edelira/LED-Sign/enclosure/img/esp32_tray.png

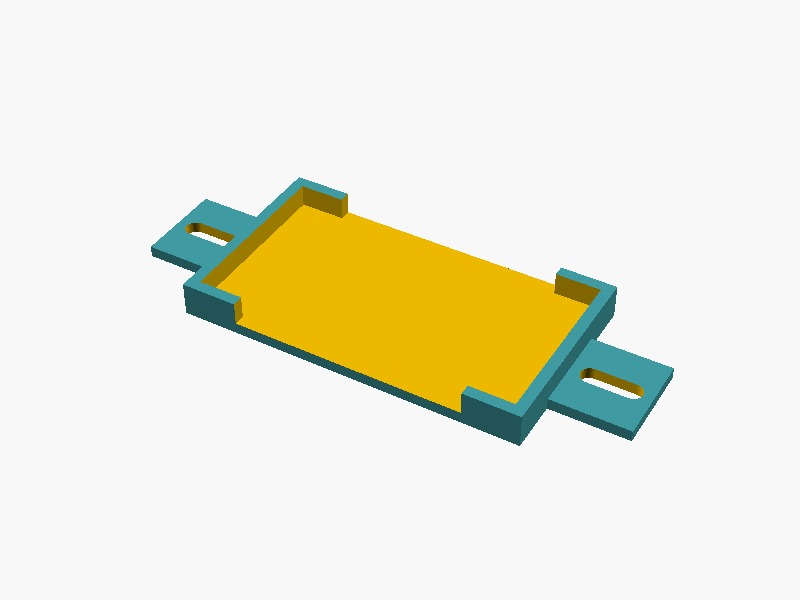
enclosure/img/esp32_tray.png
