edelira/LED-Sign/enclosure/img/hanger.png

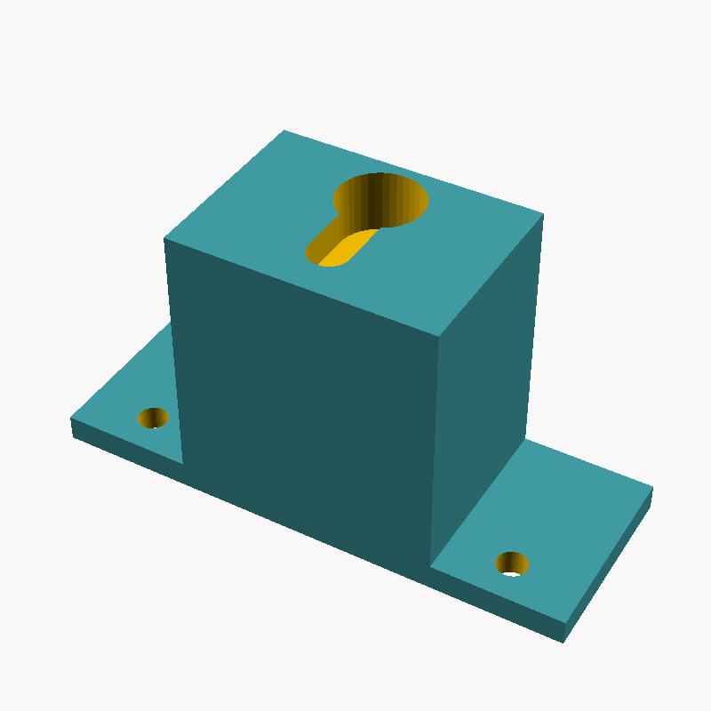
enclosure/img/hanger.png
