edelira/LED-Sign/enclosure/img/magnet_rail.png

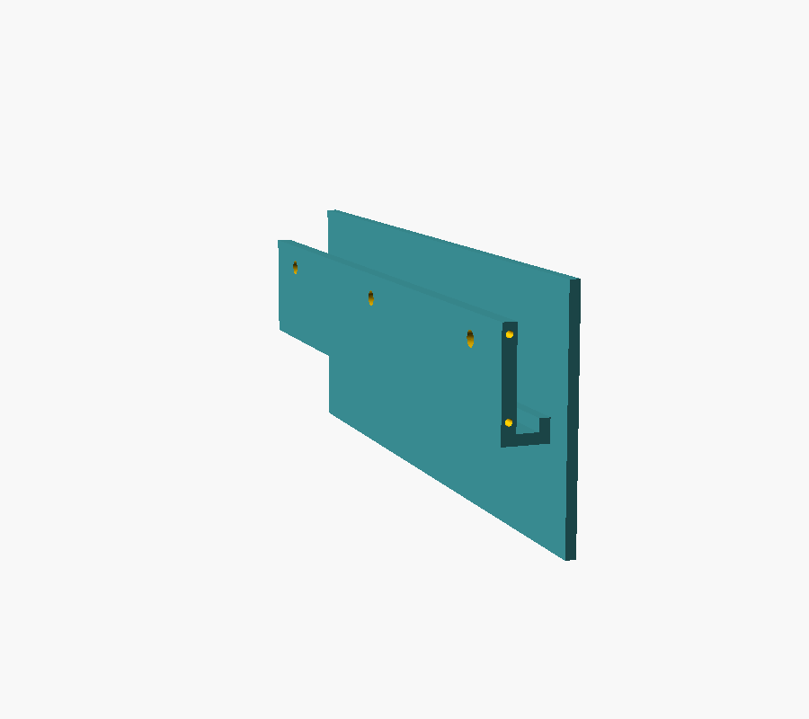
enclosure/img/magnet_rail.png
