edelira/LED-Sign/enclosure/img/magnet_rail_side.png

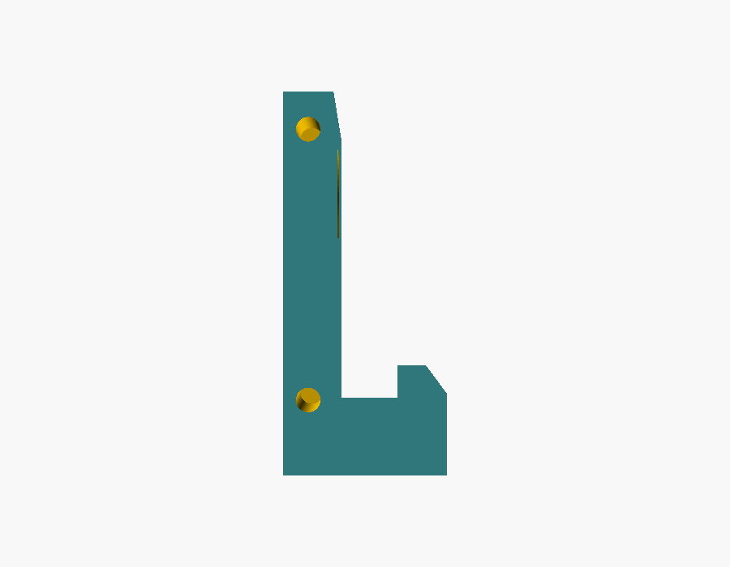
enclosure/img/magnet_rail_side.png
