edelira/LED-Sign/enclosure/img/seg_left.png

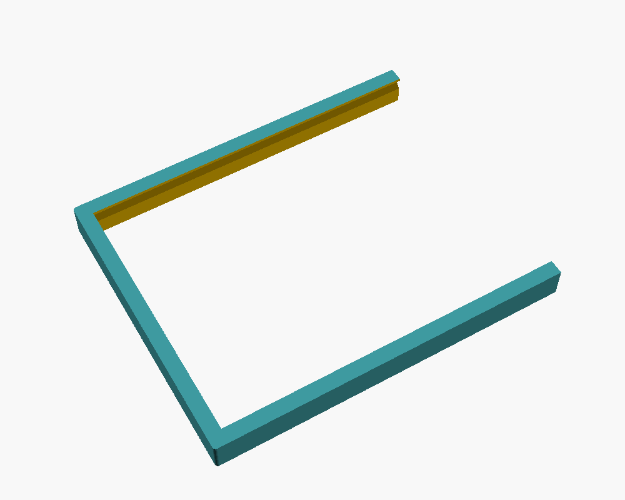
enclosure/img/seg_left.png
