edelira/LED-Sign/enclosure/stl/magnet_rail.stl

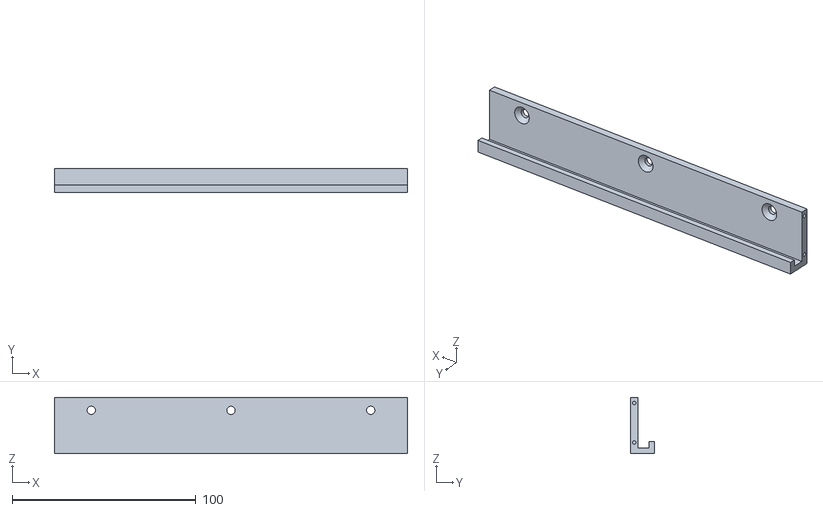
[picture p6: CAD file, 2026-10-31]
enclosure/stl/magnet_rail.stl
192.0 x 13.0 x 30.5
