edelira/LED-Sign/enclosure/stl/magnet_foot.stl

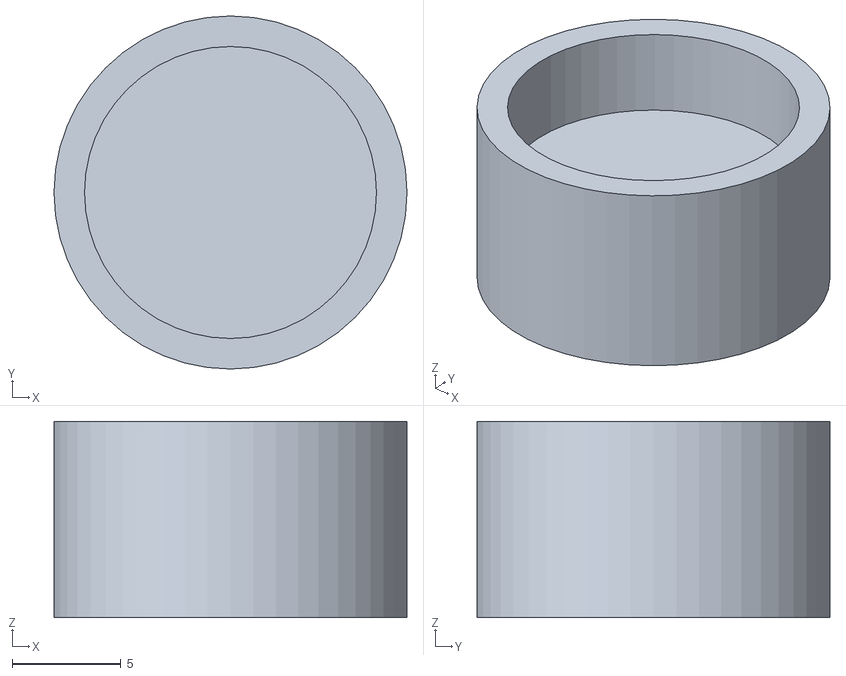
[picture p7: CAD file, 2026-10-31]
enclosure/stl/magnet_foot.stl
16.2 x 16.2 x 9.00
