edelira/LED-Sign/enclosure/stl/magnet_test.stl

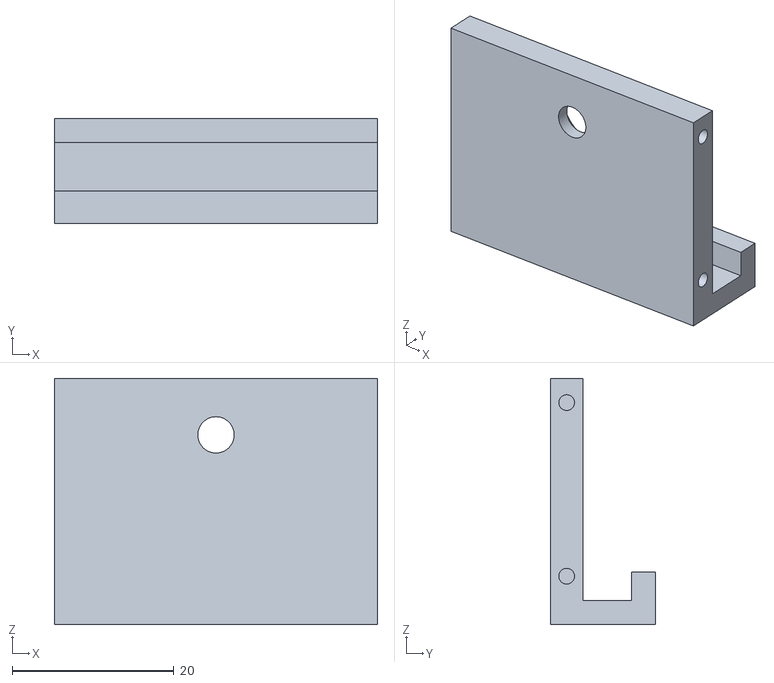
[picture p8: CAD file, 2026-10-31]
enclosure/stl/magnet_test.stl
40.0 x 13.0 x 30.5
