edelira/LED-Sign/enclosure/stl/seg_left.stl

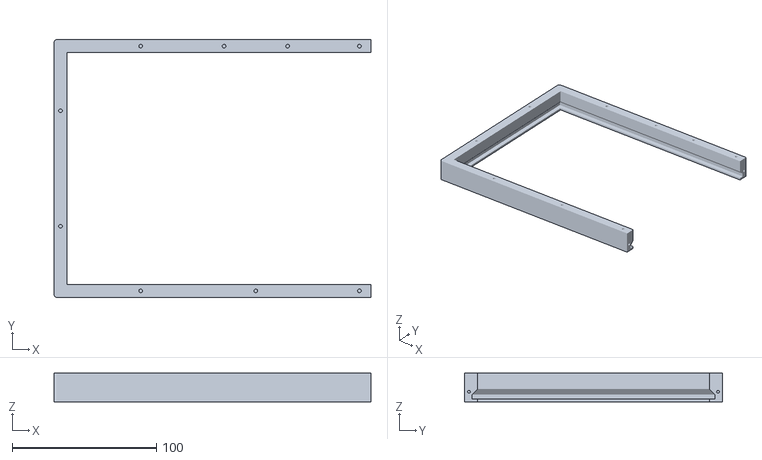
[picture p9: CAD file, 2026-10-25]
enclosure/stl/seg_left.stl
219.5 x 178.5 x 20.0
