edelira/LED-Sign/enclosure/stl/splice.stl

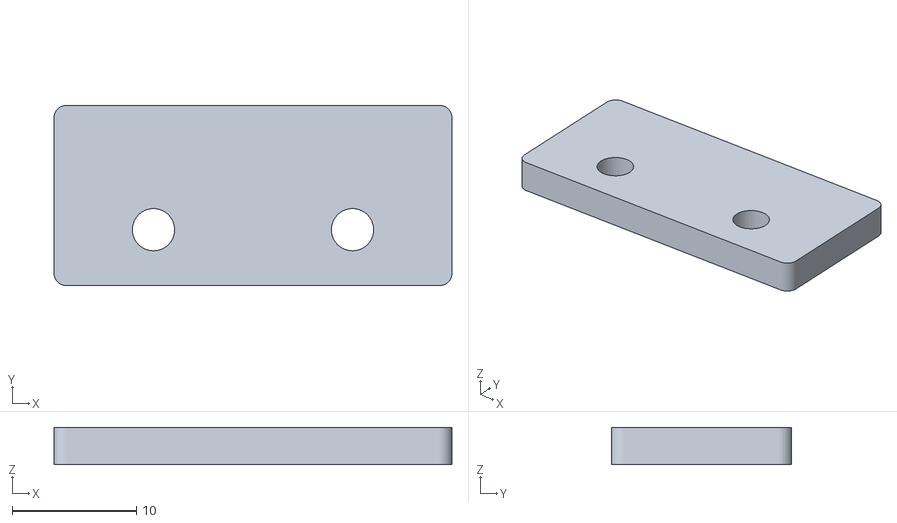
[picture p10: CAD file, 2026-10-25]
enclosure/stl/splice.stl
32.0 x 14.5 x 3.00
