edelira/LED-Sign/enclosure/stl/hanger.stl

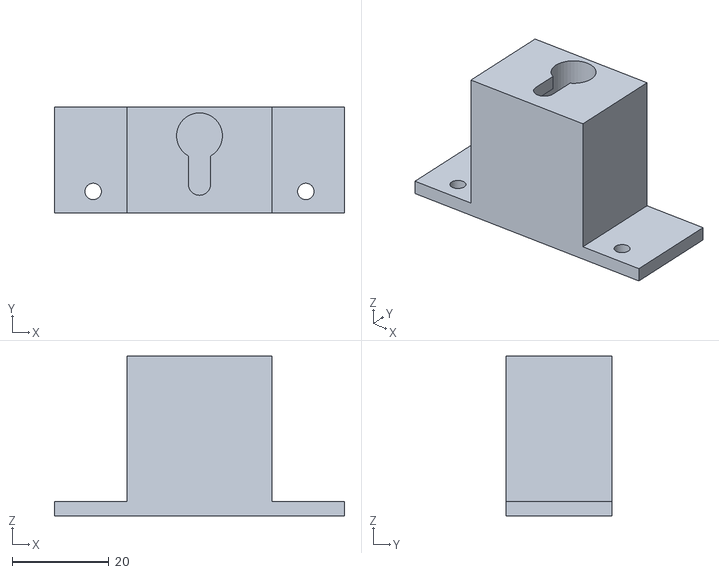
[picture p11: CAD file, 2026-10-25]
enclosure/stl/hanger.stl
60.0 x 22.0 x 33.0
