edelira/LED-Sign/enclosure/stl/seg_mid.stl

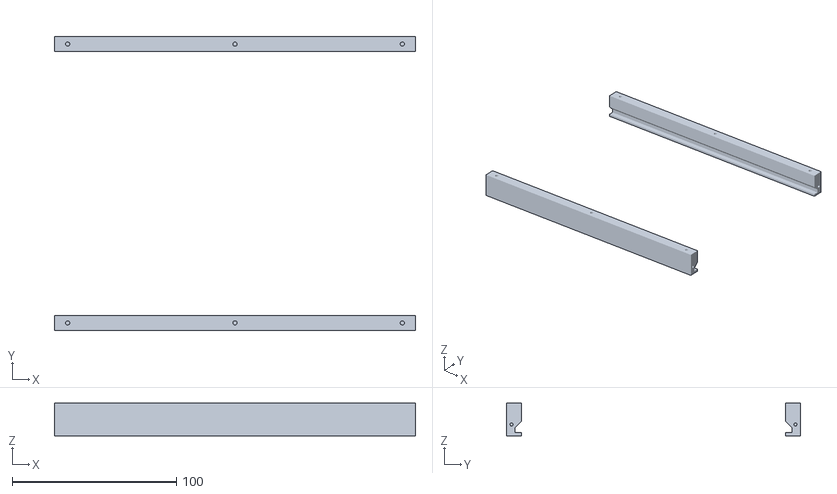
[picture p12: CAD file, 2026-10-25]
enclosure/stl/seg_mid.stl
219.5 x 178.5 x 20.0
