edelira/LED-Sign/enclosure/stl/esp32_tray.stl

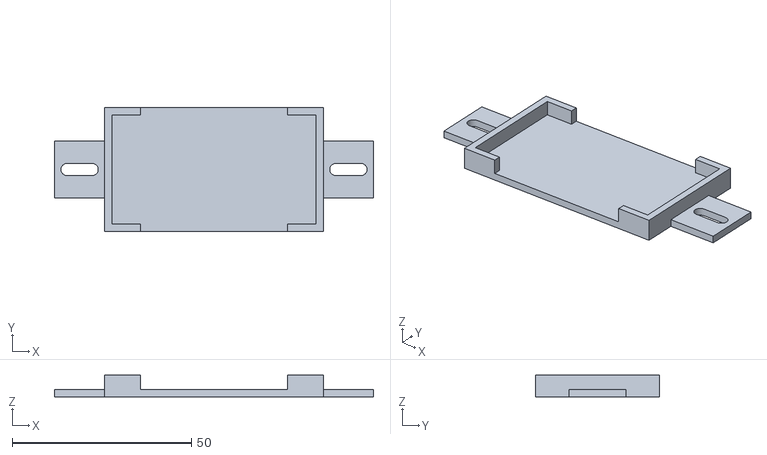
[picture p13: CAD file, 2026-10-25]
enclosure/stl/esp32_tray.stl
89.0 x 34.5 x 6.00
