edelira/LED-Sign/enclosure/stl/tab.stl

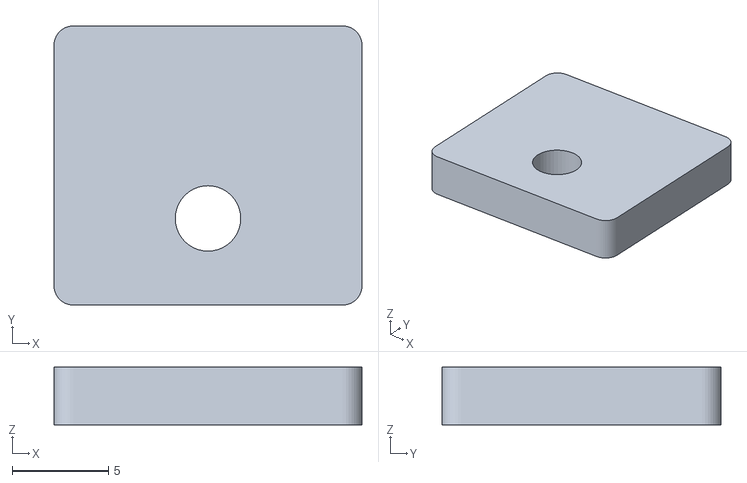
[picture p14: CAD file, 2026-10-25]
enclosure/stl/tab.stl
16.0 x 14.5 x 3.00
