edelira/LED-Sign/(list of files, cad)

Other CAD files:
enclosure/stl/seg_right.stl
