edelira/LED-Sign/enclosure/img/assembly_back.png

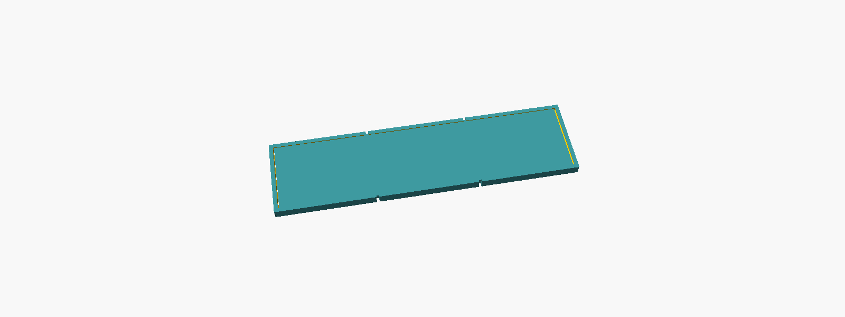
enclosure/img/assembly_back.png
