edelira/LED-Sign/(commit log)

2026-10-25 Add parametric 3D-printed frame for the 128x32 P4 sign
    OpenSCAD design for two P4 64x32 panels behind smoked acrylic, split into
    three bezel segments for a Bambu P1S, plus clamp tabs, seam splices, keyhole
    wall hangers and an ESP32 tray. STLs and preview renders included.
    Claude-Session: https://claude.ai/code/session_0147WbtXRNRrgATfYPrAWexS
    [esp32_tray.stl, frame.scad, hanger.stl, seg_left.stl, seg_mid.stl, seg_right.stl, splice.stl, tab.stl]
2026-10-25 Switch frame to P5 panels and derive hardware layout from size
    Panel size now comes from a pitch variable (P5 default, P4 still works).
    Tab, splice and hanger positions are computed from the frame size so they
    no longer collide when the sign gets bigger.
    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
    [esp32_tray.stl, frame.scad, hanger.stl, seg_left.stl, seg_mid.stl, seg_right.stl, splice.stl, tab.stl]
2026-10-28 Add ESPHome wiring test config for one 64x64 P3 panel
    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
2026-10-28 Add ESPHome config for 3x 64x64 panels on a Matrix Portal S3
    Uses the hub75 board preset, PSRAM, 8-bit colour and double buffering, with
    a panel-order test pattern (1, 2, 3 left to right).
    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
2026-10-29 Add FEATURES.md with the agreed feature list and hardware plan
    Records screens and priorities, data sources, the calibration test, the Pi
    controller plan and the parked 'now playing' idea.
    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
2026-10-31 Add sign firmware foundation: HA controls, actions, clock and weather
    The sign fetches its own time (SNTP) and weather (Open-Meteo). Home
    Assistant gets Display and Brightness controls and can push a message or a
    timer through API actions. Screen priority: timer > message > idle.
    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
2026-10-31 Add planes-overhead screen, fetched on the sign
    The sign polls adsb.lol every 10 s for the closest aircraft inside an
    adjustable radius and altitude, looks up its route on adsbdb, and shows a
    mini radar plus flight details. HA gets Show planes, Plane radius, Plane max
    altitude and an Overhead flight sensor. Exact home coordinates live only in
    the device copy in ESPHome.
    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
2026-10-31 Add Amtrak passing and kitchen now-playing screens
    Amtrak: the sign polls api.amtraker.com for trains 3/4, 5/6 and 380-383 and
    estimates when each passes the house by interpolating between its Chicago
    Union Station time and its La Grange Road or Naperville time by milepost.
    HA gets Show trains, Train offset, Train window and a Next Amtrak sensor.
    Now playing: HA pushes title, artist and album art URL; the sign downloads
    the art itself and scrolls long titles.
    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
2026-10-31 Add drop-in wall rail for the panels' magnetic screws
    A channel rail the panels' top magnetic screws drop into, plus spacer feet
    for the bottom magnets and a short test piece. Parametric for the magnet
    size.
    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
    [magnet_foot.stl, magnet_rail.scad, magnet_rail.stl, magnet_test.stl]
2026-10-31 Keep the sign responsive when the internet or DNS is down
    - Home Assistant as a second time source, so the clock works without NTP.
    - 4 s HTTP timeout and a 2 min pause after any failed request, so slow or
    failing sites no longer freeze the display or block Wi-Fi installs.
    - No train/plane fetches until the time is set; retry weather until it loads.
    - Uptime and Last restart reason sensors.
    - Move album art to the image: online_image platform (old form deprecated).
    - Panels set to 3.
    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
    [led-sign.yaml]
2026-10-31 Move HTTPS and Wi-Fi buffers to PSRAM
    With three panels and double buffering the DMA buffers leave only a few KB
    of internal RAM, so HTTPS connections failed to allocate. Let mbedTLS and
    Wi-Fi/lwIP use PSRAM, add a Free memory sensor, and only retry weather once
    Wi-Fi is up.
    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
    [led-sign.yaml]
2026-11-01 Get weather from Home Assistant instead of Open-Meteo
    The sign reads weather.forecast_home (condition and temperature) and the
    LED Sign today high/low template sensors over the local API, so weather no
    longer needs an HTTPS download on the device.
    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
2026-11-01 Give the Home Assistant weather sensors ids (ESPHome requires one)
    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
2026-11-01 Sign only draws: drop on-device fetching, add show_train/show_plane actions
    The Matrix Portal was too busy with blocking HTTPS requests to keep its
    Home Assistant connection. Home Assistant now fetches planes and Amtrak and
    pushes them through new show_train, show_plane and clear_plane actions.
    Plane radius/altitude and train window/offset move to HA helpers.
    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
2026-11-01 Use the FM6124 shift driver to stop green ghost streaks
    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
2026-11-01 Drop the FM6124 shift driver; use latch blanking for green ghosting
    shift_driver: FM6124 left the HUB75 DMA uninitialised on the Matrix
    Portal S3 (flip_buffer() called but DMA not initialized), so the
    display stopped updating. Go back to the generic driver and blank OE
    for two clock cycles around each latch instead.
    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
    [led-sign.yaml]
2026-11-01 Refresh the panels at 120 Hz to stop the faint pulsing
    A fixed update_interval makes ESPHome derive the panel refresh rate
    from it (~40 Hz at 80 ms), which shows as a slight flicker. Set
    update_interval: never with min_refresh_rate: 120 and redraw the
    content from an 80 ms interval instead.
    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
    [led-sign.yaml]
2026-11-01 Animate the train-passing screen; drop the idle clock/weather divider
    A new train first runs across all three panels (locomotive and three
    cars, direction of travel, Amtrak or freight colours), then the info
    screen shows cars rolling past on the left panel. The screen redraws
    at 25 fps while a train is shown and 12.5 fps otherwise.
    The dotted line between the clock and the weather looked out of
    place, so the idle screen no longer draws it.
    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
    [led-sign.yaml]
2026-11-01 Glide planes on the radar between position updates
    HA sends a position every ~10 s. Between updates the sign now moves the
    plane along its heading at its ground speed (capped at 15 s), and clips
    the radar to the left panel so a gliding plane never draws over text.
    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
2026-11-01 Shared screens: music + timer bar + Bears strip; game-day screens
    - Timer runs as a bar along the top of whatever is showing, and only
    takes the full screen for its last minute and TIME'S UP.
    - Music: album art left, title, artist, big time and weather (no source
    label). Shrinks to fit under the timer bar / above the Bears strip.
    - Bears (from HA): kickoff preview in the weather spot, live score strip
    with team logos and colours, scoreboard for 15 s after each score,
    TOUCHDOWN screen, and final score for 15 min after the game.
    - 32 NFL logos from ESPN baked in at build time (28 px and 13 px).
    - '&' in song titles is spelled out (the font has no ampersand).
    - Radar 'N' marker moved to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
2026-11-01 Centre non-square album art on its panel
    Wide covers (16:9 video thumbnails) were shrunk to fit the width and sat
    at the top of the panel, looking cut off.
    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
2026-11-03 Rotate the clock screen's third panel through cards
    Weather always; tomorrow's forecast after 7 PM; the Bears kickoff preview
    on game day (it used to replace the weather all day); and TRASH TOMORROW
    while HA's trash reminder is on. 8 s per card.
    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
    [led-sign.yaml]
2026-11-04 Weather from HA's fallback sensors; keep the last good reading
    Read sensor.led_sign_temperature / led_sign_weather_condition (Met.no,
    falling back to Open-Meteo) instead of weather.forecast_home, and ignore
    unavailable/NaN updates so a Met.no outage no longer shows NO WX. A dim
    dot in the corner marks weather more than 3 hours old.
    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
    [led-sign.yaml]
2026-11-04 Animated weather icons, livelier with heavier weather
    Calm breathing sun, crescent moon with twinkling stars at night, drifting
    clouds and fog, and rain / snow / storm / wind that get denser and faster
    with HA's 0-2 intensity (sensor.led_sign_weather_intensity). Labels stay
    the same at every level; Met.no's 'pouring' now just says RAIN.
    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
    [led-sign.yaml]
2026-11-04 Lower the cloudy icon so the back cloud isn't cut off at the top
    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
2026-11-04 Even out the music screen's spacing; stack PARTLY / CLOUDY
    The music screen left an empty band under the time; the title, artist,
    divider and time/weather now spread evenly down the panel. Partly cloudy
    on the clock screen moves the temperature up and shows PARTLY over
    CLOUDY (one-line PT CLOUDY elsewhere).
    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
2026-11-05 Music screen: green TRASH/TMRW tag swaps with the weather the night before pickup
    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
    [led-sign.yaml]
2026-11-05 Wall vibration sensor (on-board LIS3DH) to detect passing freight trains
    Reads the accelerometer FIFO at 100 Hz, reports the strongest 1 s RMS every
    5 s as "Vibration" (mg), and "Wall rumble" when it stays above the
    adjustable "Vibration threshold" for 15 s. Test phase: nothing on the display.
    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
    [led-sign.yaml]
2026-11-05 Vibration: back off 30 s after an I2C failure, give up after 5
    A failing LIS3DH transfer blocks up to 100 ms; retrying every 150 ms starved
    the display loop and Wi-Fi (clock ticking, animations frozen, API offline).
    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
    [led-sign.yaml]
2026-11-05 Revert "Vibration: back off 30 s after an I2C failure, give up after 5"
    This reverts commit d4831ec3e28cffa604a7f4885100b2e0f797846b.
    [led-sign.yaml]
2026-11-05 Remove the wall vibration sensor (back to the pre-LIS3DH firmware)
    Reading the on-board LIS3DH stalled the display loop and Wi-Fi on the sign.
    Reverts fb3e982 and d4831ec.
    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
    [led-sign.yaml]
